UMSAE-Formula-Electric/PCB-ACU-Latching/Project Outputs for ePBR20_ACU_Latching/ePBR20_ACU_Latching.xlsx

Supplier Part Number 1 | Comment | Description | Designator | Footprint | LibRef | Quantity
RT424F12-ND | 5-1393243-4 | Electromechanical Relay 12VDC 240Ohm 15A DPDT __ 29mm 12.7mm 15.7mm__ THT Power Relay | AMS, BSPD, IMD | TE_5-1393243-4 | 5-1393243-4 | 3
 | Test Via |  | BSPD_TIME | Test Via | Test VIa | 1
490-10991-1-ND | Cap Semi | Capacitor (Semiconductor SIM Model) | C1 | 1608[0603] | Cap Semi | 1
445-11189-1-ND, 490-10991-1-ND | Cap | Capacitor | C2, C3, C4 | 1608[0603] | Cap | 3
399-6856-1-ND, [NoParam] | 100nF | CAP CER 0.1UF 50V X7R 0603 | C5, C6, C7, C8, C9 | 1608[0603] | 0805C-100nF-25V-X7R-MUR | 5
475-2512-1-ND | AMS_ERR | LED, Red 0603 (1608) 63mCd | D1 | TOSH-0603LED_RED_V | CMP-0444-00001-1 | 1
475-2512-1-ND | IMD_ERR | LED, Red 0603 (1608) 63mCd | D2 | TOSH-0603LED_RED_V | CMP-0444-00001-1 | 1
475-2512-1-ND | BSPD_ERR | LED, Red 0603 (1608) 63mCd | D3 | TOSH-0603LED_RED_V | CMP-0444-00001-1 | 1
SZNUP1301ML3T1GOSCT-ND | SZNUP1301ML3T1G | Low Capacitance Diode Array for ESD Protection in a Single Data Line, 3-Pin SOT-23, Pb-Free, Tape and Reel | D4, D11 | ONSC-SOT-23-3-318-08_V | CMP-1063-00171-1 | 2
641-1015-1-ND | D Zener | Zener Diode | D5, D6, D7, D8, D9, D10 | DO214AC | D Zener | 6
DDZ5V6ASF-7DICT-ND | D Zener | Zener Diode | D12 | DIODE_SOD323_101 | D Zener | 1
A32920-ND | 5-535541-4 |  | J1, J2, J3, J4 | 5-535541-4_5-535541-4(Primary) | 5-535541-4 | 4
S1012E-02-ND | Header 2 | Header, 2-Pin | JMP1, JMP2, JMP3 | 2Pin Jumper | Header 2 | 3
S9337-ND | Jumper |  | Jumper1, Jumper2, Jumper3 |  | Jumper | 3
CLP6C-RKW-CYBA0AA3CT-ND | 3 LEDs |  | LED1 | 3 channel led | CLP6C-RKW-CYBA0AA3 | 1
DMG3406L-13DICT-ND |  | N-Channel MOSFET | Q1, Q2, Q3, Q4, Q5, Q6, Q7, Q8, Q9, Q10, Q11, Q12, Q13 | SOT-23_N | MOSFET-N | 13
A129685CT-ND | 560 | 0603 (1608 Metric) Chip Resistor | R1, R14, R19, R23 | RESC0603(1608)_L | CMP-1591-00001-1 | 4
311-10KGRCT-ND, 311-1.00MHRCT-ND, 311-100HRDKR-ND, YAG3633CT-ND, 311-20.0KHRCT-ND | Volt. Div. R2 | RES SMD 20K OHM 5% 1/4W 0603 | R2, R3, R4, R7, R8, R11, R12, R13, R34, R50, R53, R54, R57 | 1608[0603] | Res1 | 13
311-100KHRCT-ND, 311-6.8KGRCT-ND, 311-300KGRCT-ND, 311-0.0GRCT-ND, 311-200KGRCT-ND, YAG3633CT-ND | Volt. Div. R1 | RES SMD 6.8K OHM 5% 1/4W 0603, RES SMD 0.0 OHM JUMPER 1/4W 0603, RES SMD 10K OHM 5% 1/4W 0603 | R5, R6, R9, R10, R30, R42, R43, R44, R55, R56 | 1608[0603] | Res1 | 10
311-1.0KGRCT-ND | 1k | Resistor | R15, R16, R48 | 1608[0603] | Res1 | 3
311-1.0KGRCT-ND | 1k | 0603 (1608 Metric) Chip Resistor | R17, R22, R40 | RESC0603(1608)_L | CMP-1591-00001-1 | 3
311-10KGRCT-ND | 10k | 0603 (1608 Metric) Chip Resistor | R18, R20 | RESC0603(1608)_L | CMP-1591-00001-1 | 2
311-27KGRCT-ND | 27k | 0603 (1608 Metric) Chip Resistor | R21 | RESC0603(1608)_L | CMP-1591-00001-1 | 1
311-1.0KGRCT-ND, 311-10KGRCT-ND | Res1 | RES SMD 100 OHM 5% 1/4W 0603, RES SMD 10K OHM 5% 1/4W 0603, RES SMD 2.2K OHM 5% 1/4W 0603 | R24, R26, R27, R29, R31, R32, R33, R35, R36, R37, R39, R41, R47, R52 | 1608[0603] | Res1 | 14
311-10KGRCT-ND | RHM1.0KDCT-ND | RES SMD 1.0K OHM 5% 1/4W 0603 | R25, R28, R38, R45, R46, R49 | 1608[0603] | Res1 | 6
311-1.00MHRCT-ND | 1000K | 0603 (1608 Metric) Chip Resistor | R51 | RESC0603(1608)_L | CMP-1591-00001-1 | 1
P17.4AATR-ND | 18 | 0603 (1608 Metric) Chip Resistor | RES | RESC0603(1608)_L | CMP-1591-00001-1 | 1
S7000-ND | Header 2 | Header, 2-Pin | TEST | 2 Pin Connector | Header 2 | 1
475-2512-1-ND | LED0 | Typical INFRARED GaAs LED | TSA | 1608[0603] | LED0 | 1
296-12848-1-ND | LM293DR | IC Dual Comparator | U1, U2 | LM293DR | LM293DR | 2
296-6501-2-ND, 296-6501-1-ND | NE555DR | Precision Timer, 4.5 to 16 V, 0 to 70 degC, 8-Pin SOIC (D8), Green (RoHS & no Sb/Br), Tape and Reel | U3, U7 | D0008A_M | CMP-1685-00007-1 | 2
296-18587-2-ND | OR Gate |  | U4 | SOT23-6_M | 4-input OR Gate | 1
296-11601-1-ND | SN74LVC1G08DBVR |  | U5 | SSOP5-P-0.95 | SN74LVC1G08DBVR | 1
296-26093-1-ND | LM317LCPK |  | U6 | LM317LCPK | LM317LCPK | 1
