UMSAE-Formula-Electric/PCB-ACU-Latching/Schematics/ePBR20_ACU_Latching_rev0.pdf

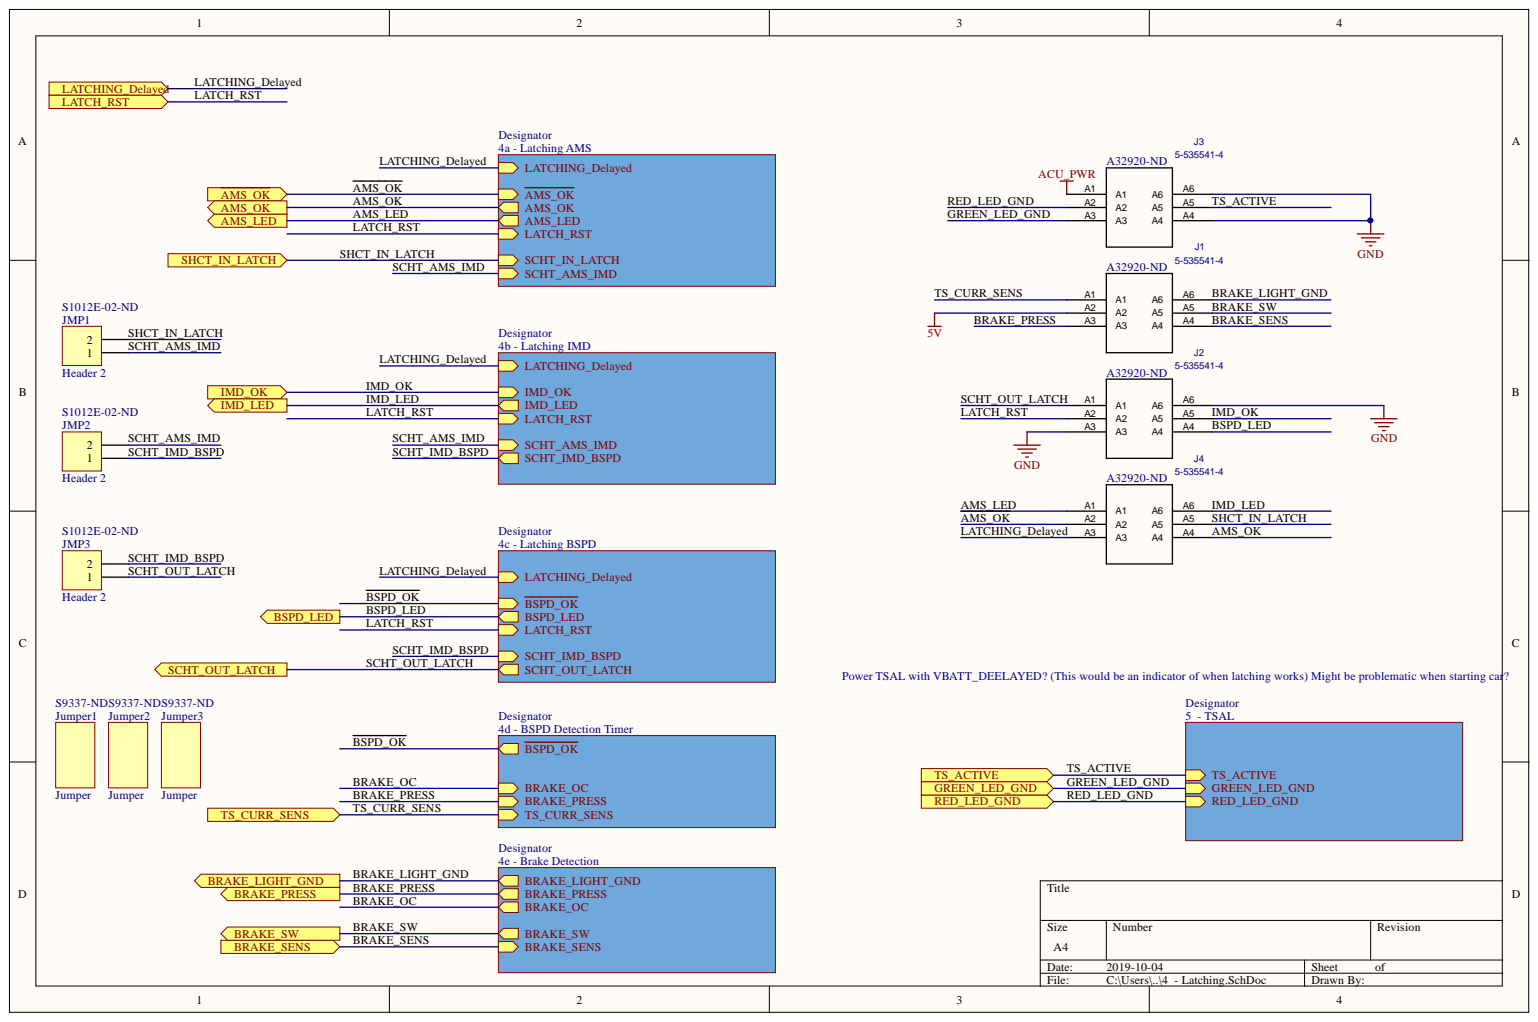
[picture p16: page 1]

Power TSAL with VBATT_DEELAYED? (This would be an indicator of when latching works) Might be problematic when starting car?

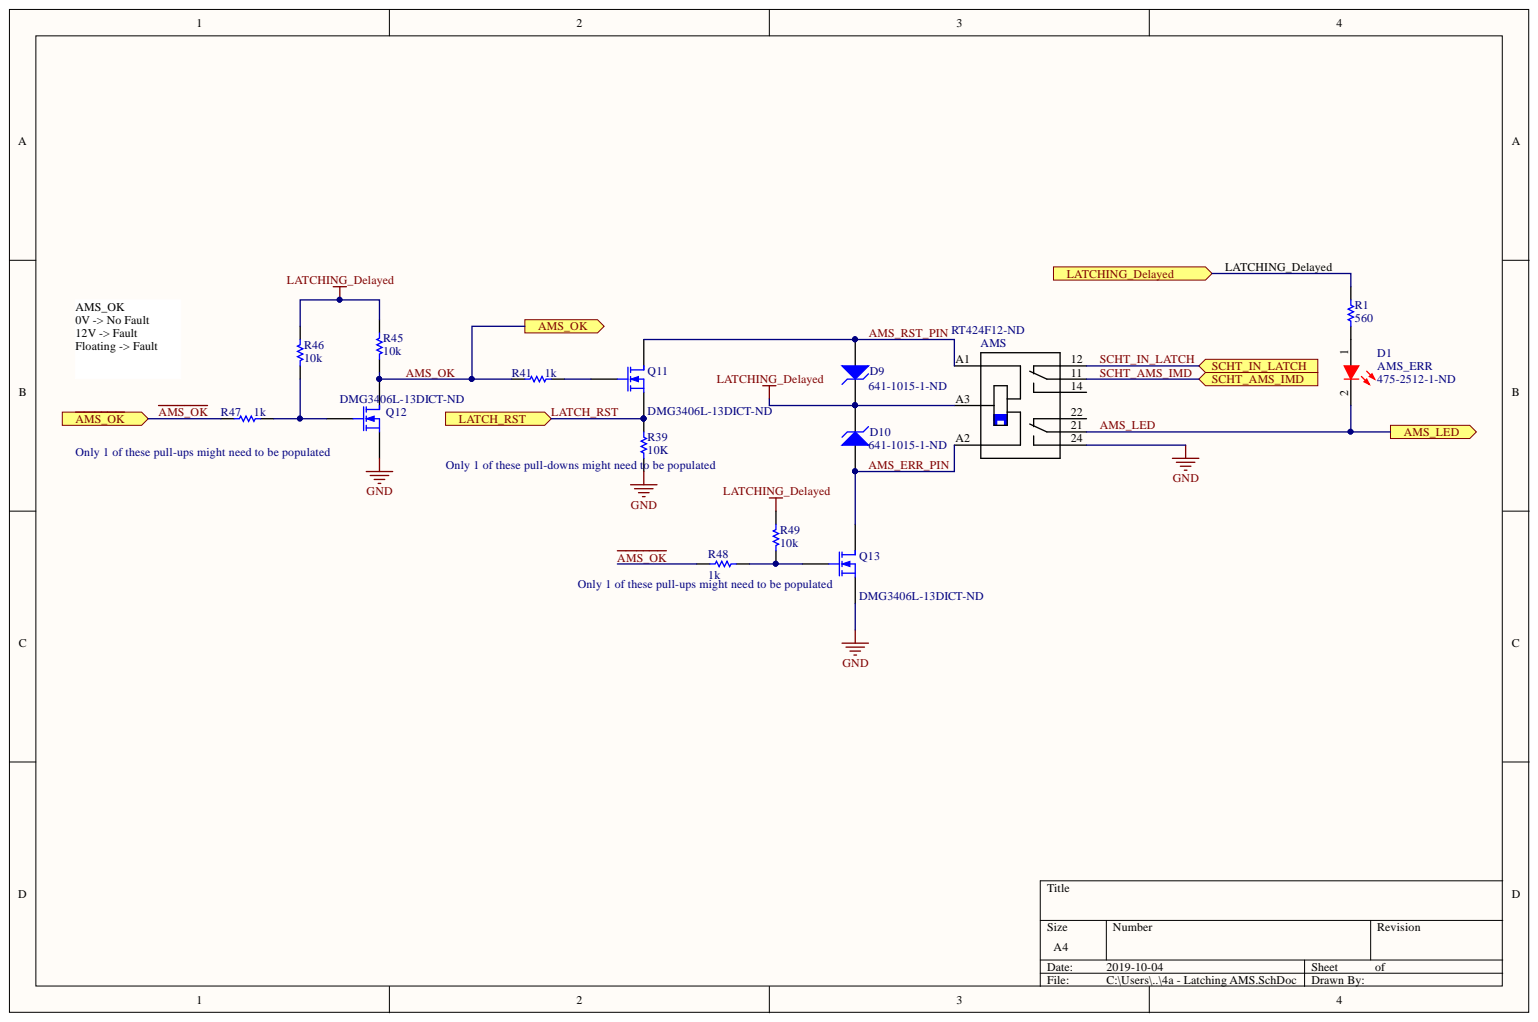
[picture p17: page 2]

Only 1 of these pull-ups might need to be populated

Only 1 of these pull-downs might need to be populated

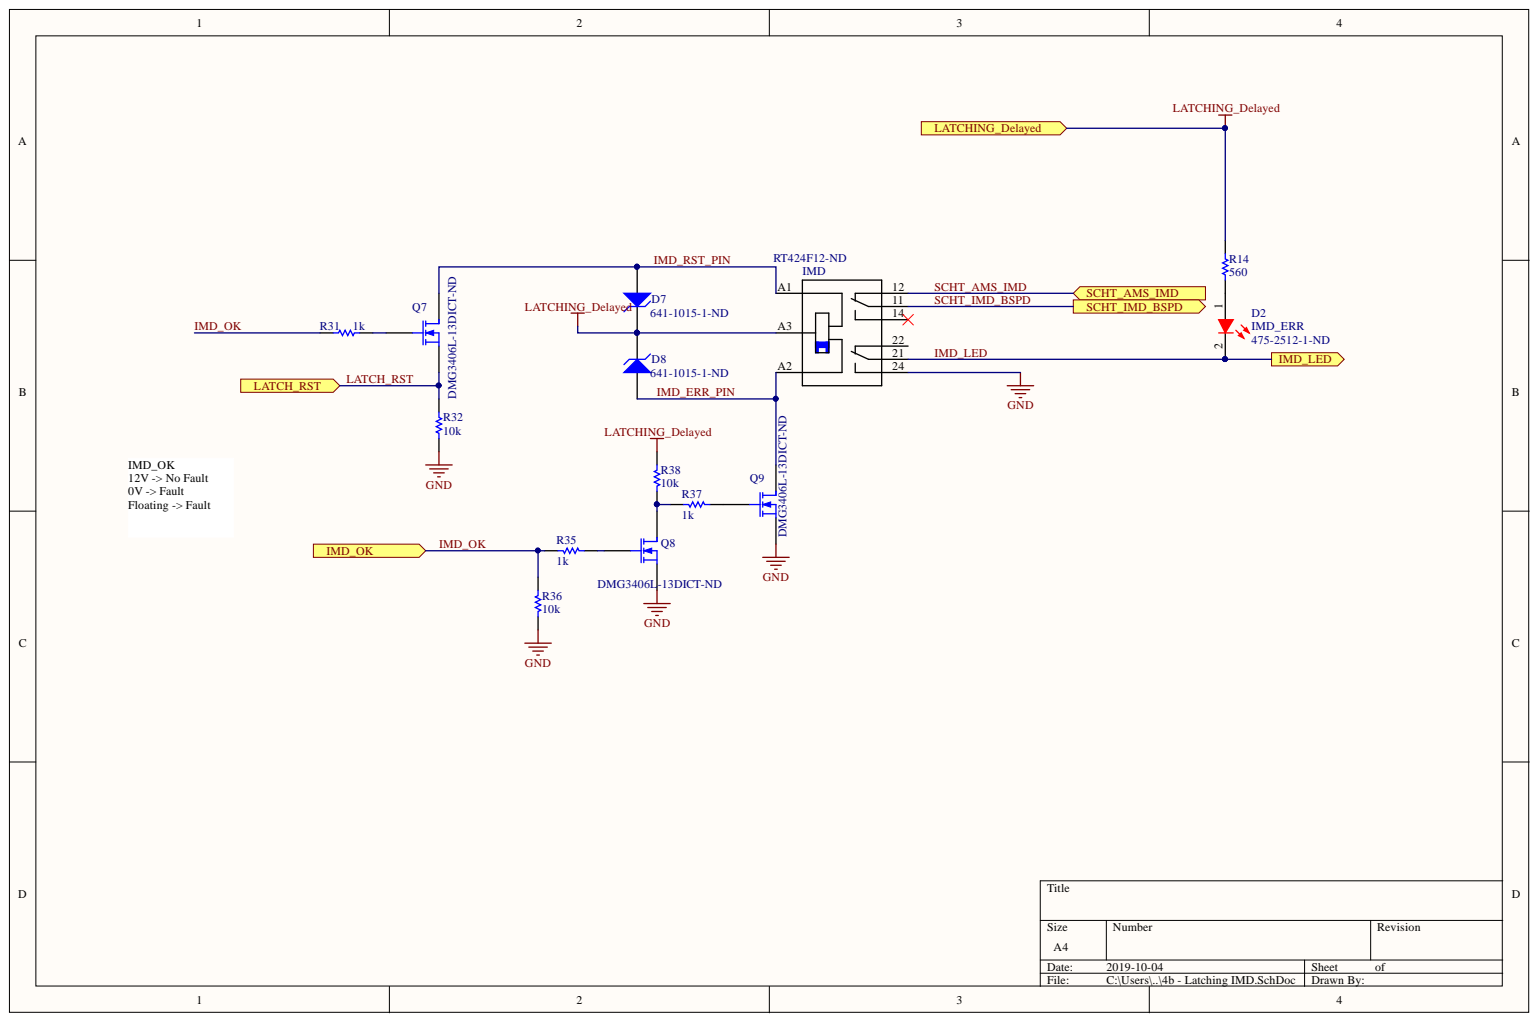
[picture p18: page 3]

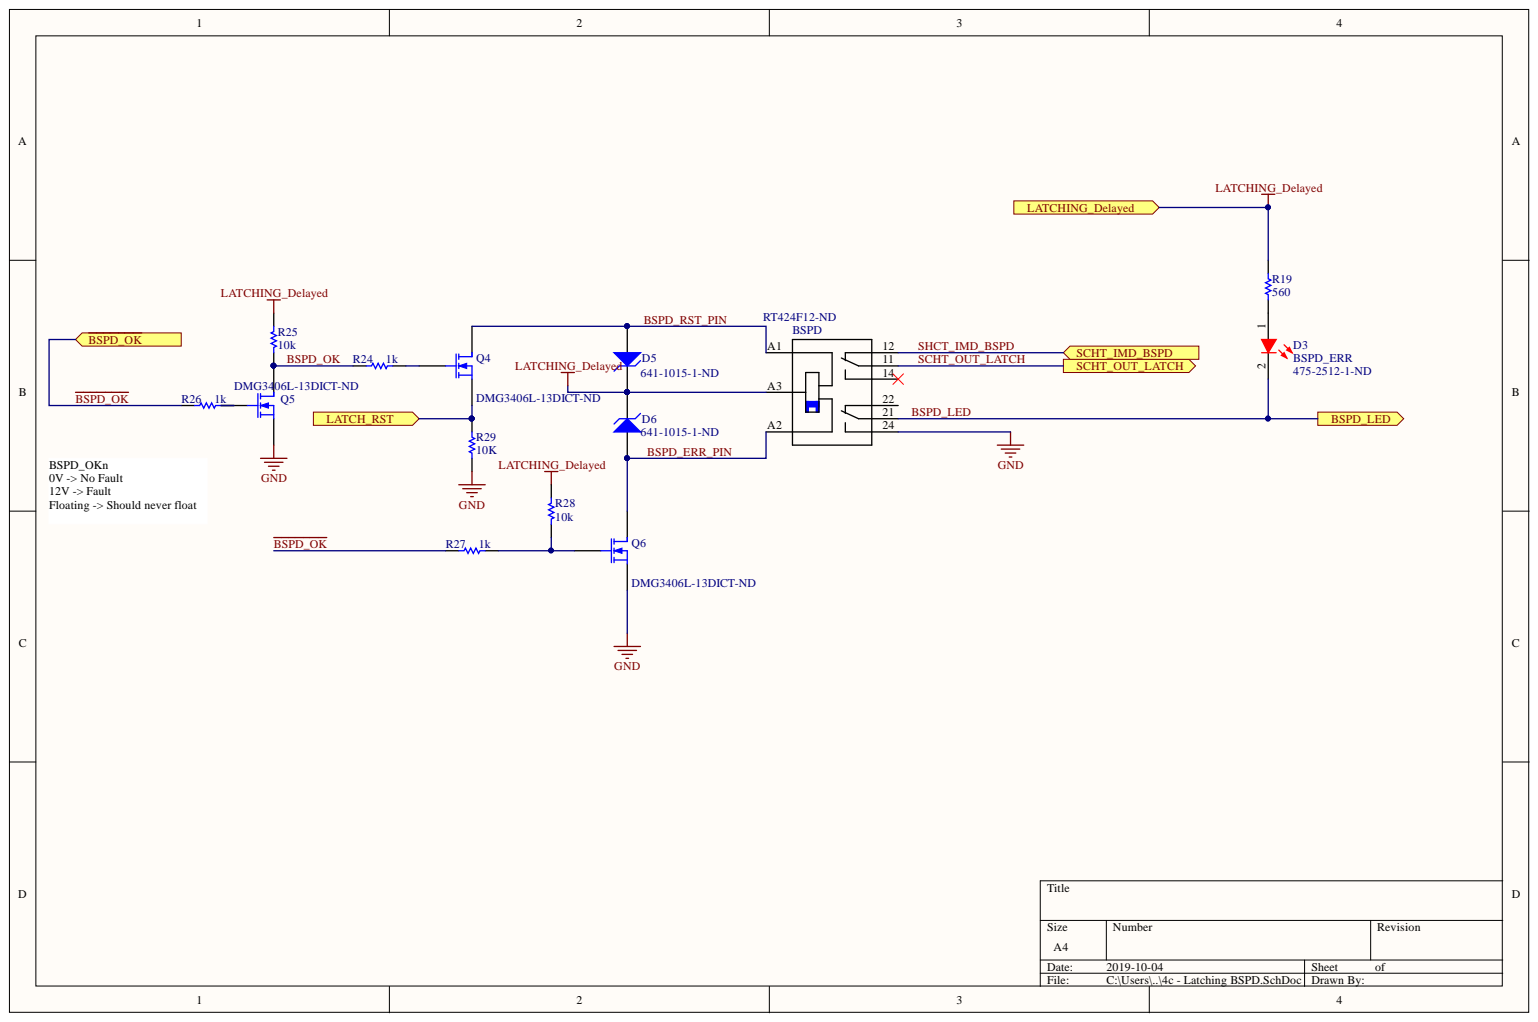
[picture p19: page 4]

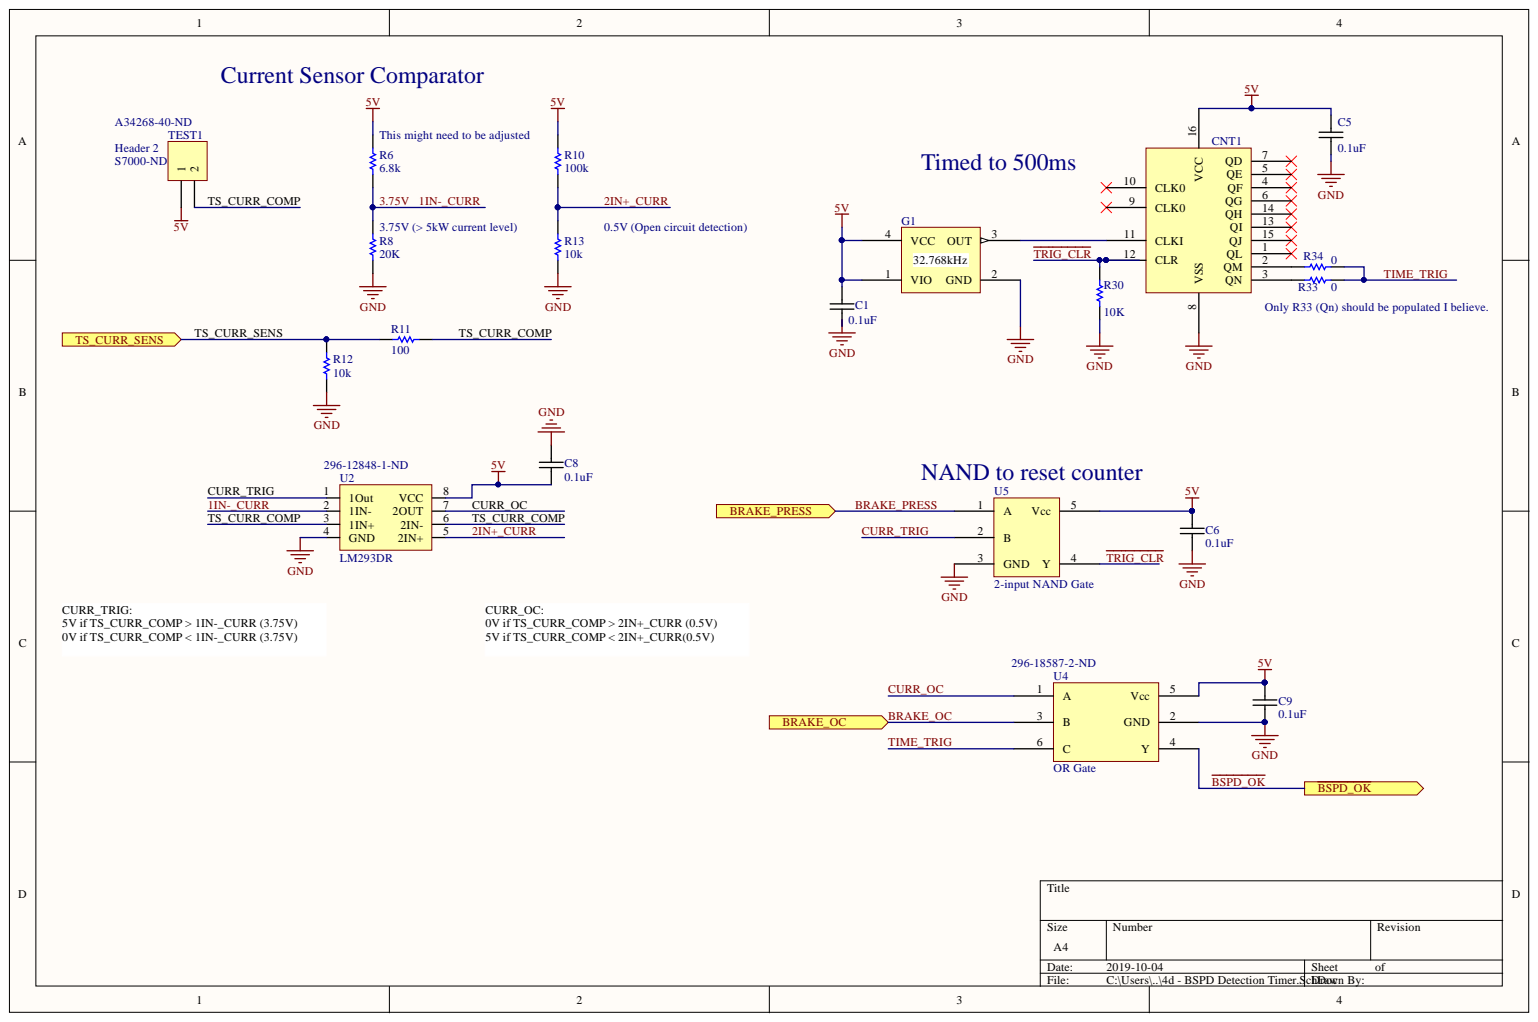
[picture p20: page 5]

This might need to be adjusted

Only R33 (Qn) should be populated I believe.

NAND to reset counter

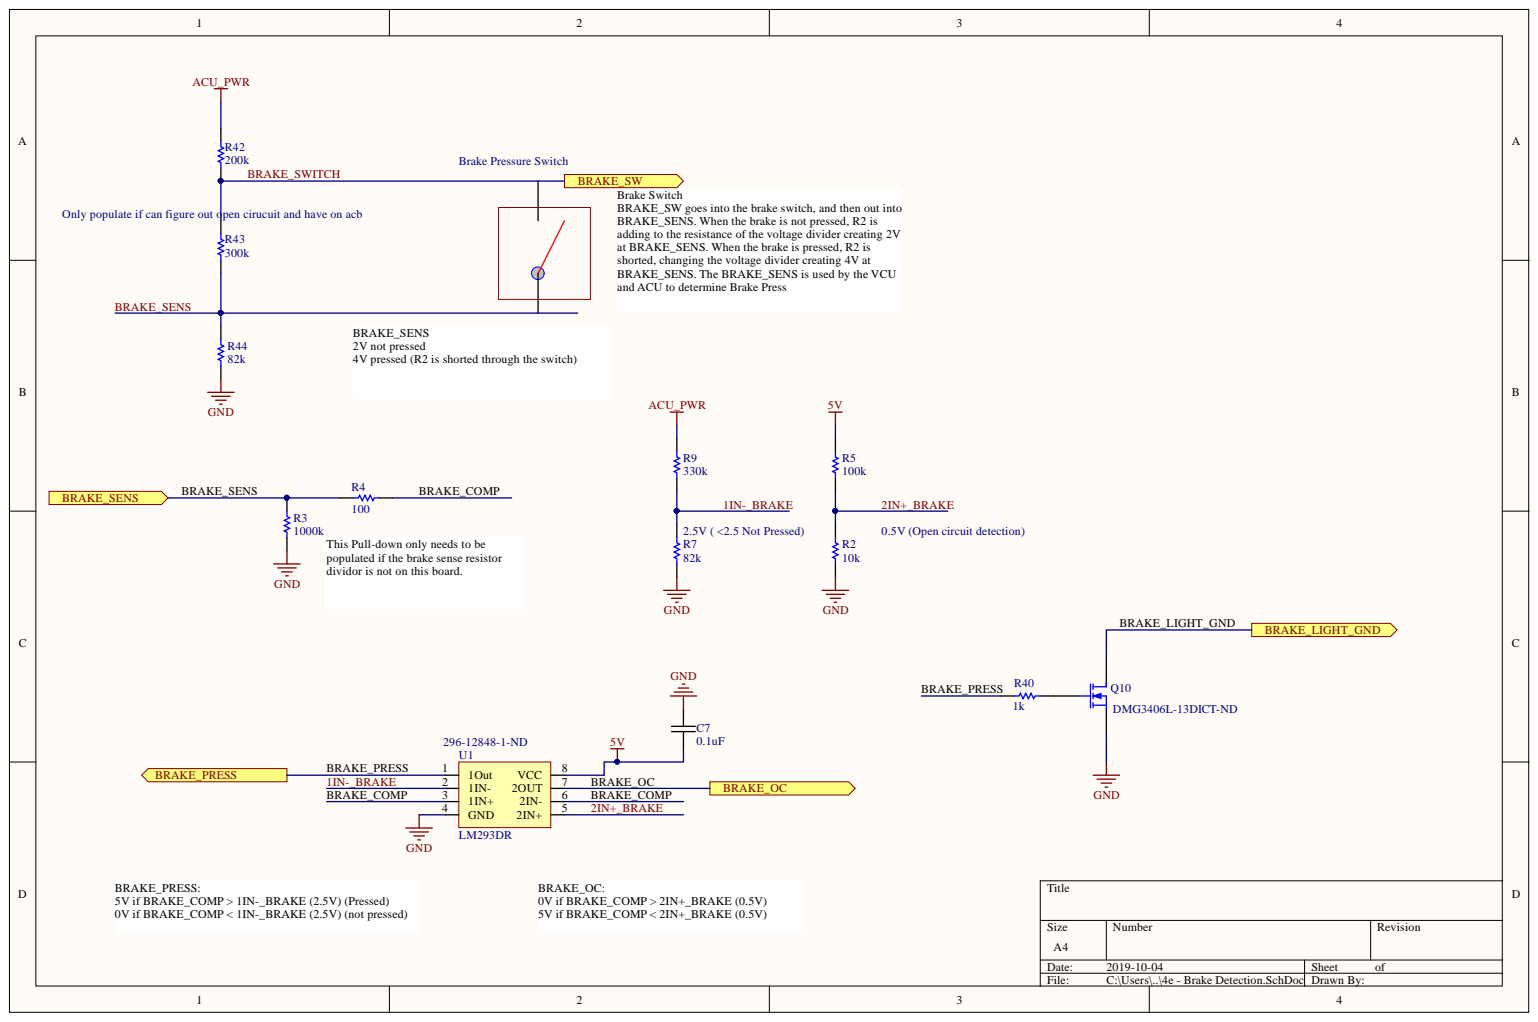
[picture p21: page 6]

Brake Switch
BRAKE_SW goes into the brake switch, and then out into
BRAKE_SENS. When the brake is not pressed, R2 is
adding to the resistance of the voltage divider creating 2V
at BRAKE_SENS. When the brake is pressed, R2 is
shorted, changing the voltage divider creating 4V at
BRAKE_SENS. The BRAKE_SENS is used by the VCU
and ACU to determine Brake Press

Only populate if can figure out open cirucuit and have on acb

BRAKE_SENS
2V not pressed
4V pressed (R2 is shorted through the switch)

This Pull-down only needs to be
populated if the brake sense resistor
dividor is not on this board.

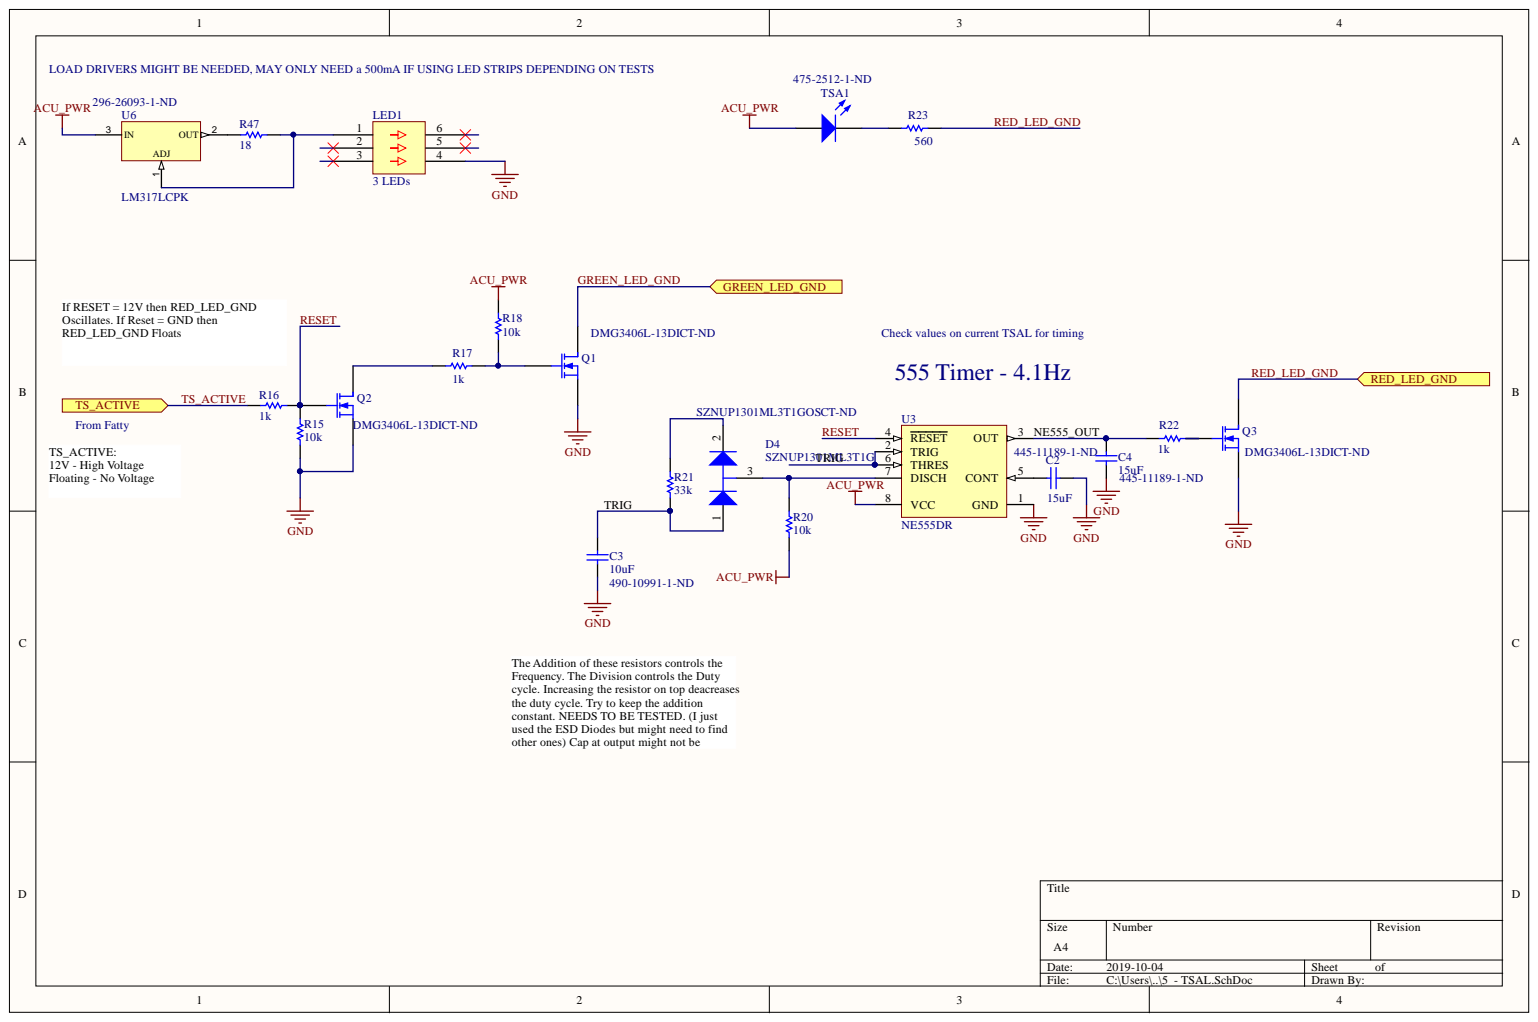
[picture p22: page 7]

LOAD DRIVERS MIGHT BE NEEDED, MAY ONLY NEED a 500mA IF USING LED STRIPS DEPENDING ON TESTS

If RESET = 12V then RED_LED_GND
Oscillates. If Reset = GND then
RED_LED_GND Floats

Check values on current TSAL for timing
555 Timer - 4.1Hz

The Addition of these resistors controls the
Frequency. The Division controls the Duty
cycle. Increasing the resistor on top deacreases
the duty cycle. Try to keep the addition
constant. NEEDS TO BE TESTED. (I just
used the ESD Diodes but might need to find
other ones) Cap at output might not be

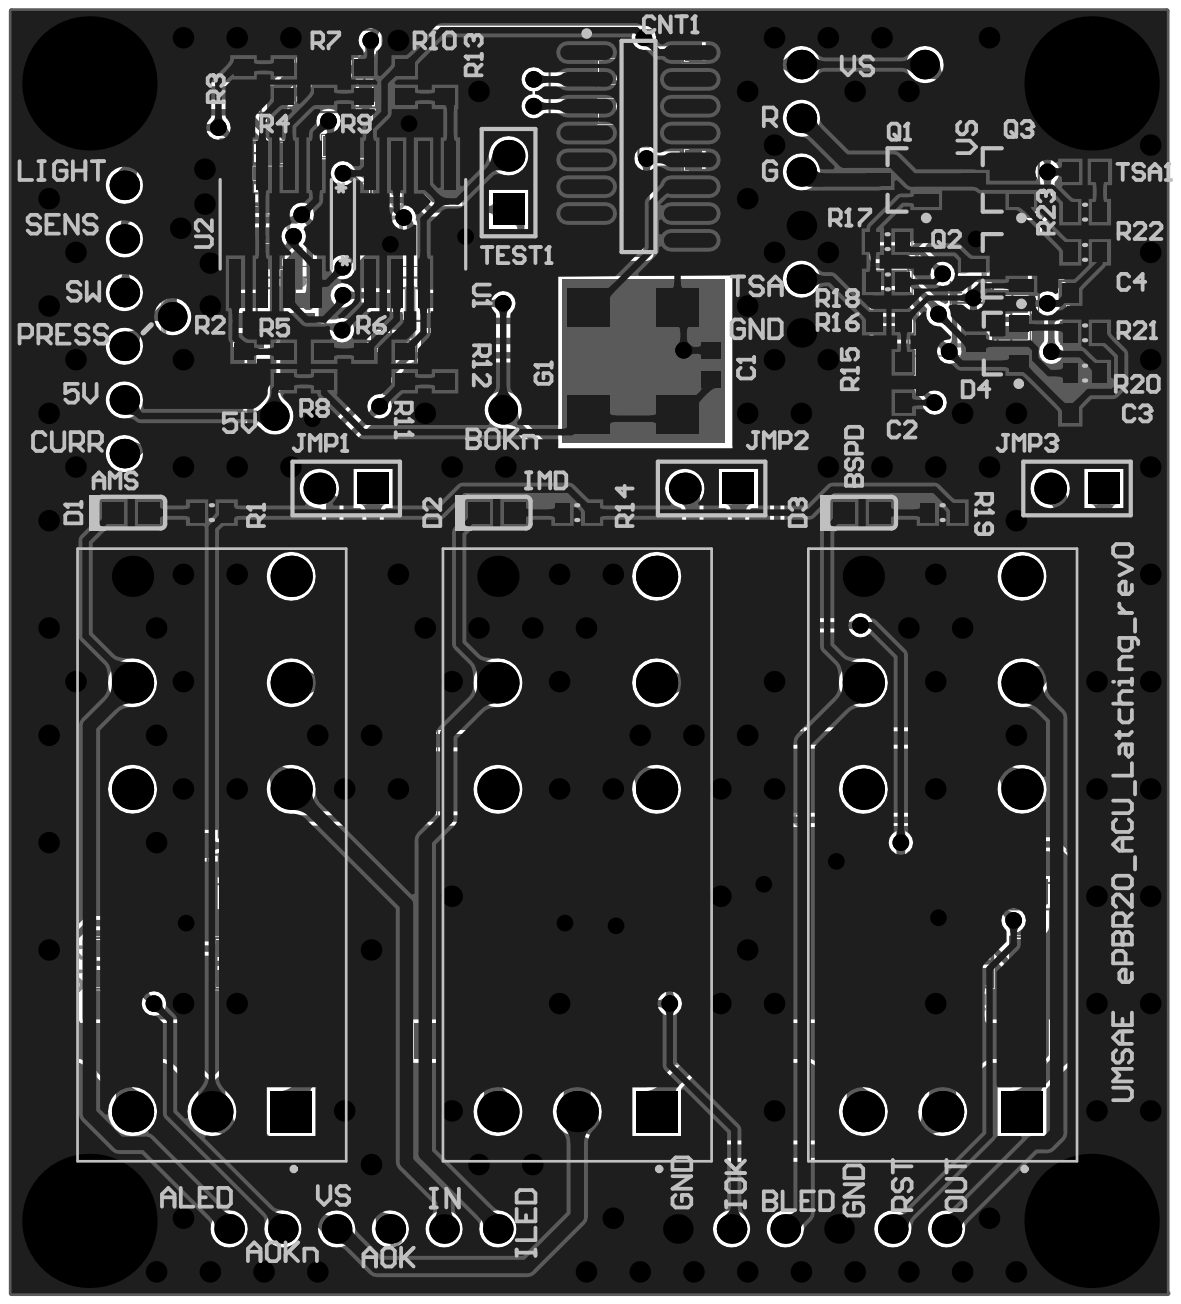
[picture p23: page 8]
