UMSAE-Formula-Electric/PCB-ACU-Latching/(list of files, drawings)

Other design files:
4 - Latching.SchDoc
4a - Latching AMS.SchDoc
4b - Latching IMD.SchDoc
4c - Latching BSPD.SchDoc
4d - BSPD Detection Timer.SchDoc
4e - Brake Detection.SchDoc
5 - Status Lights.SchDoc
ACB_lib.SchLib
ePBR25_ACU_Latching.PrjPCB
Miscellaneous Devices.PcbLib
Miscellaneous Devices.SchLib
