UMSAE-Formula-Electric/PCB-ACU-Latching/(commit log)

2021-02-06 ePBR20 Latching Archive
    Contains rev0 and rev1. Note that previous latching boards were integrated into the main acu controller board.
    [4 - Latching.SchDoc, 4a - Latching AMS.SchDoc, 4b - Latching IMD.SchDoc, 4c - Latching BSPD.SchDoc, 4d - BSPD Detection Timer.SchDoc, 4e - Brake Detection.SchDoc, 5 - TSAL.SchDoc, ACB_lib.SchLib]
2021-09-20 ePBR22 rev0
    rev0 commit for ePBR22
    [4 - Latching.SchDoc, 4a - Latching AMS.SchDoc, 4b - Latching IMD.SchDoc, 4c - Latching BSPD.SchDoc, 5 - TSAL.SchDoc, ePBR20_ACU_Latching.PrjPCB]
2022-10-30 Board name change
2022-10-30 File name change
    [ePBR20_ACU_Latching.PrjPCB, ePBR23_ACU_Latching.PrjPCB]
2022-10-30 Main file name change
    [ePBR23_ACU_Latching.PrjPCB]
2022-11-24 Gerber files and NC drill holes generated
    [ePBR23_ACU_Latching_rev0.GBL, ePBR23_ACU_Latching_rev0.GBO, ePBR23_ACU_Latching_rev0.GBP, ePBR23_ACU_Latching_rev0.GBS, ePBR23_ACU_Latching_rev0.GTL, ePBR23_ACU_Latching_rev0.GTO, ePBR23_ACU_Latching_rev0.GTP, ePBR23_ACU_Latching_rev0.GTS]
2022-11-24 Zipped gerber file
2022-12-02 ePBR23 Latching Nov22
    Latching rev0 of ePBR23 printed in November 2022
2022-12-02 ePBR23 Latching Dec22
    [ePBR23_ACU_Latching_rev0.GBL, ePBR23_ACU_Latching_rev0.GBO, ePBR23_ACU_Latching_rev0.GBP, ePBR23_ACU_Latching_rev0.GBS, ePBR23_ACU_Latching_rev0.GTL, ePBR23_ACU_Latching_rev0.GTO, ePBR23_ACU_Latching_rev0.GTP, ePBR23_ACU_Latching_rev0.GTS]
2022-12-02 ePBR23 Latching Dec22 Final
    [ePBR23_ACU_Latching.PrjPCB]
2024-10-06 File and Name Change
    Changed File name from ePBR23 to ePBR25
    [ePBR23_ACU_Latching.PrjPCB, ePBR25_ACU_Latching.PrjPCB]
2024-10-06 File name change 2.0
    [ePBR25_ACU_Latching.PrjPCB]
2024-10-15 Removed TSAL circuitry
    - Kept the 555 Timer that causes creates PWM Signal
    [4e - Brake Detection.SchDoc, 5 - TSAL.SchDoc, ePBR25_ACU_Latching.PrjPCB]
2024-10-18 Added Safety Status Circuitry
    [4 - Latching.SchDoc, 4a - Latching AMS.SchDoc, 4b - Latching IMD.SchDoc, 4c - Latching BSPD.SchDoc, 4d - BSPD Detection Timer.SchDoc, 4e - Brake Detection.SchDoc, 5 - Status Lights.SchDoc, 5 - TSAL.SchDoc]
2024-10-18 Imported Safety Status components to PC
    [4 - Latching.SchDoc, 5 - Status Lights.SchDoc, Miscellaneous Devices.PcbLib, Miscellaneous Devices.SchLib, ePBR25_ACU_Latching.PrjPCB]
2024-10-27 Increased PCB Size
2024-10-28 Updating PCB latching board
    Updating PCB latching board
2024-10-28 Updating Latching board
    Updating Latching board
2024-10-28 Still updating Latching Board
2024-10-28 Fixed up Schematics on new ciruitry
    [4 - Latching.SchDoc, 4a - Latching AMS.SchDoc, 4b - Latching IMD.SchDoc, 4c - Latching BSPD.SchDoc, 4d - BSPD Detection Timer.SchDoc, 4e - Brake Detection.SchDoc, 5 - Status Lights.SchDoc, ePBR25_ACU_Latching.PrjPCB]
2024-10-28 Safety Status Circuitry Complete
    [4 - Latching.SchDoc, 5 - Status Lights.SchDoc]
2024-11-24 Reorganized Status Light Circuit
    Removed one of the mounting holes to allow more room for circuit.
    [4 - Latching.SchDoc, 4e - Brake Detection.SchDoc, 5 - Status Lights.SchDoc, ePBR25_ACU_Latching.PrjPCB]
2024-12-01 Final check
    [4b - Latching IMD.SchDoc, 5 - Status Lights.SchDoc]
2024-12-01 Resistors Added for IMD and AMS
    [5 - Status Lights.SchDoc]
2025-01-19 BMS and IMD Schematic Neatness
    [4a - Latching AMS.SchDoc, 4b - Latching IMD.SchDoc]
2025-02-17 Latchinf Fix
    Fix relays for dashlight faults
    Fix circuit for status light power
    [4 - Latching.SchDoc, 4a - Latching AMS.SchDoc, 4b - Latching IMD.SchDoc, 4c - Latching BSPD.SchDoc, 4e - Brake Detection.SchDoc, 5 - Status Lights.SchDoc]
2025-05-06 Update 4d - BSPD Detection Timer.SchDoc
    Adjusted value R52 and R51 to 100ohm and 50k respectively due to timer no sending an output
    [4d - BSPD Detection Timer.SchDoc]
